fermitron2048/pfd/(commit log)

2019-12-27 Added sensor data and csv2bin.py
    [sensordata.bin.csv]
2019-12-27 Added Arduino code for sensor packs
2020-01-02 Added README.md for sensor packs
